LzxOL/nuedc2024-e-master/(list of files, drawings)

Other design files:
电赛7_25.epro
